pontusAndersson/CyclingHourglass/images/2N3906-Pinout.jpg

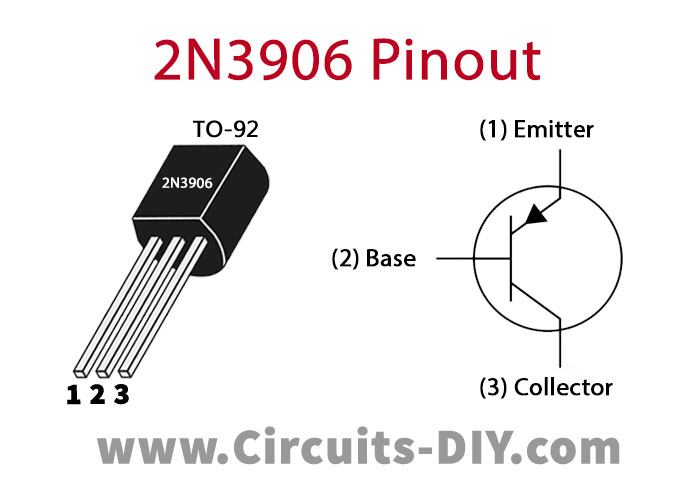
images/2N3906-Pinout.jpg
