pontusAndersson/CyclingHourglass/Schematic/Transponder/BOM.md

# TransponderV3 BOM

Listan, TME-länkar, batteri och bygge ligger i [README.md](README.md).

Orderarkiv: [TME-order-35407144.csv](TME-order-35407144.csv).
