pontusAndersson/CyclingHourglass/images/build imgs/amplifier front.png

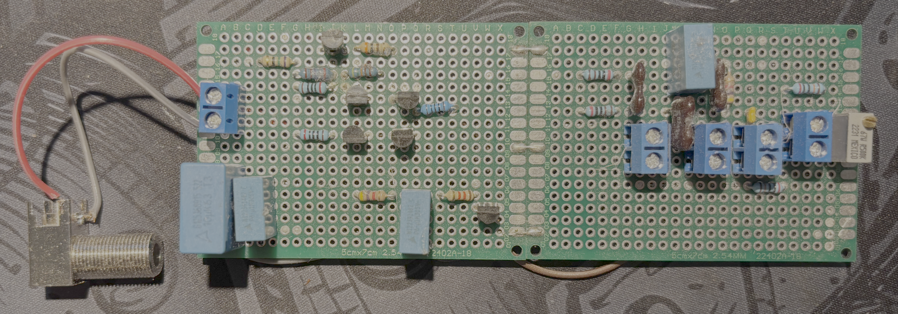
images/build imgs/amplifier front.png
