pontusAndersson/CyclingHourglass/Schematic/Decoder/Decoder.pdf

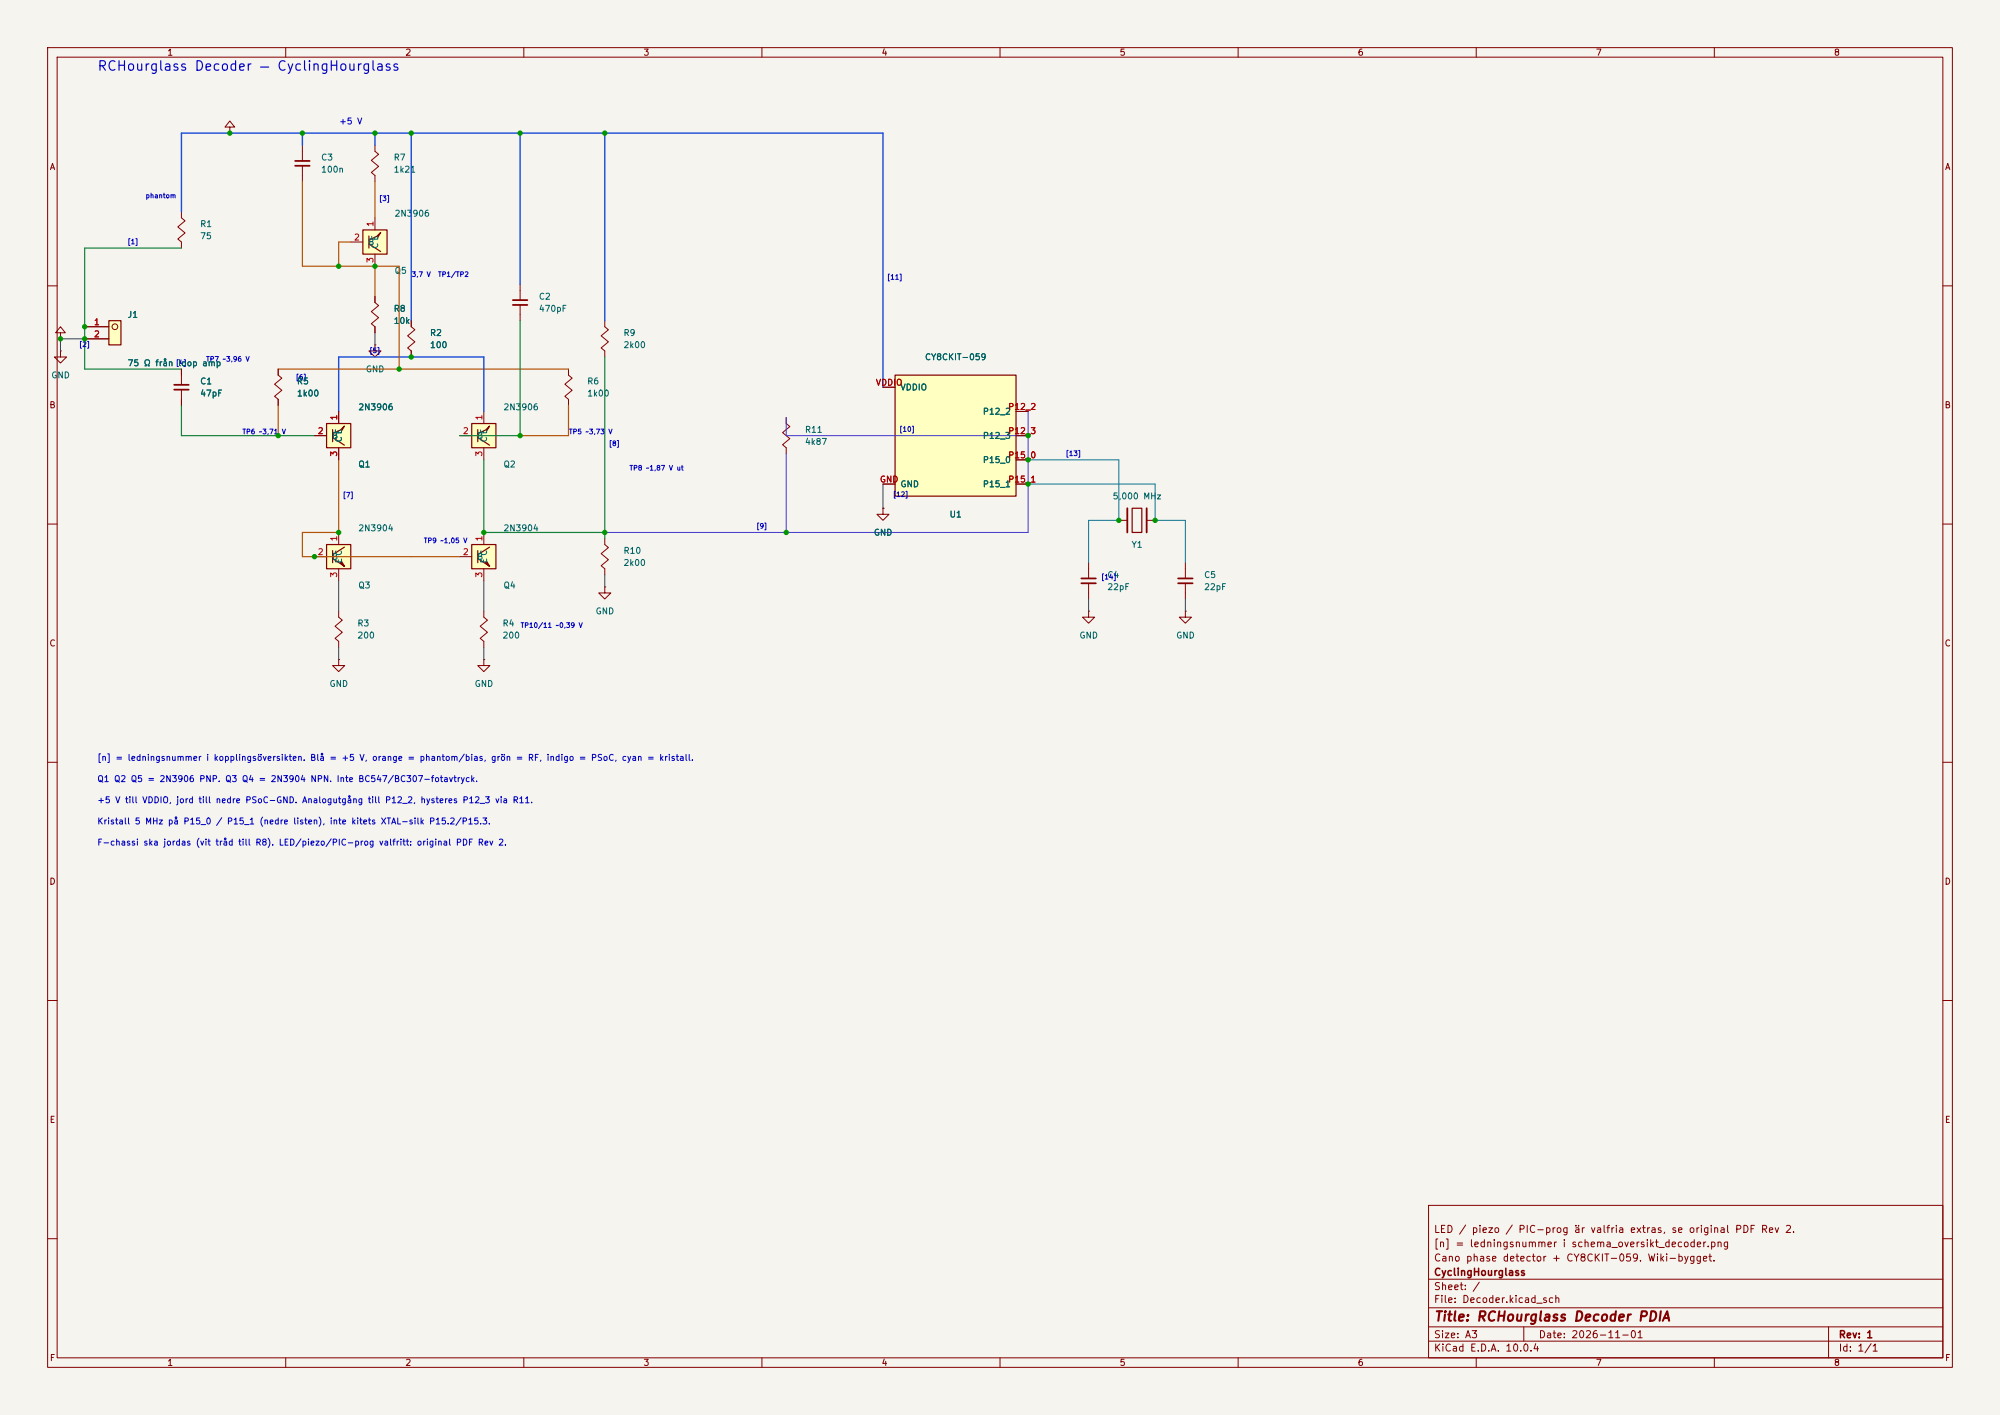
[picture p53: page 1]

[12] [n] = ledningsnummer i kopplingsöversikten. Blå = +5 V, orange = phantom/bias, grön = RF, indigo = PSoC, cyan = kristall. +5 V till VDDIO, jord till nedre PSoC-GND. Analogutgång till P12_2, hysteres P12_3 via R11. F-chassi ska jordas (vit tråd till R8). LED/piezo/PIC-prog valfritt: original PDF Rev 2.

Q1 Q2 Q5 = 2N3906 PNP. Q3 Q4 = 2N3904 NPN. Inte BC547/BC307-fotavtryck. Kristall 5 MHz på P15_0 / P15_1 (nedre listen), inte kitets XTAL-silk P15.2/P15.3.

LED / piezo / PIC-prog är valfria extras, se original PDF Rev 2.
[n] = ledningsnummer i schema_oversikt_decoder.png
Cano phase detector + CY8CKIT-059. Wiki-bygget.
CyclingHourglass
Sheet: /
File: Decoder.kicad_sch
Title: RCHourglass Decoder PDIA

Size: A3 | Rev: 1
KiCad E.D.A. 10.0.4 | Id: 1/1 | F Date: 2026-11-01
