pontusAndersson/CyclingHourglass/Schematic/Decoder/LoopAmplifier.pdf

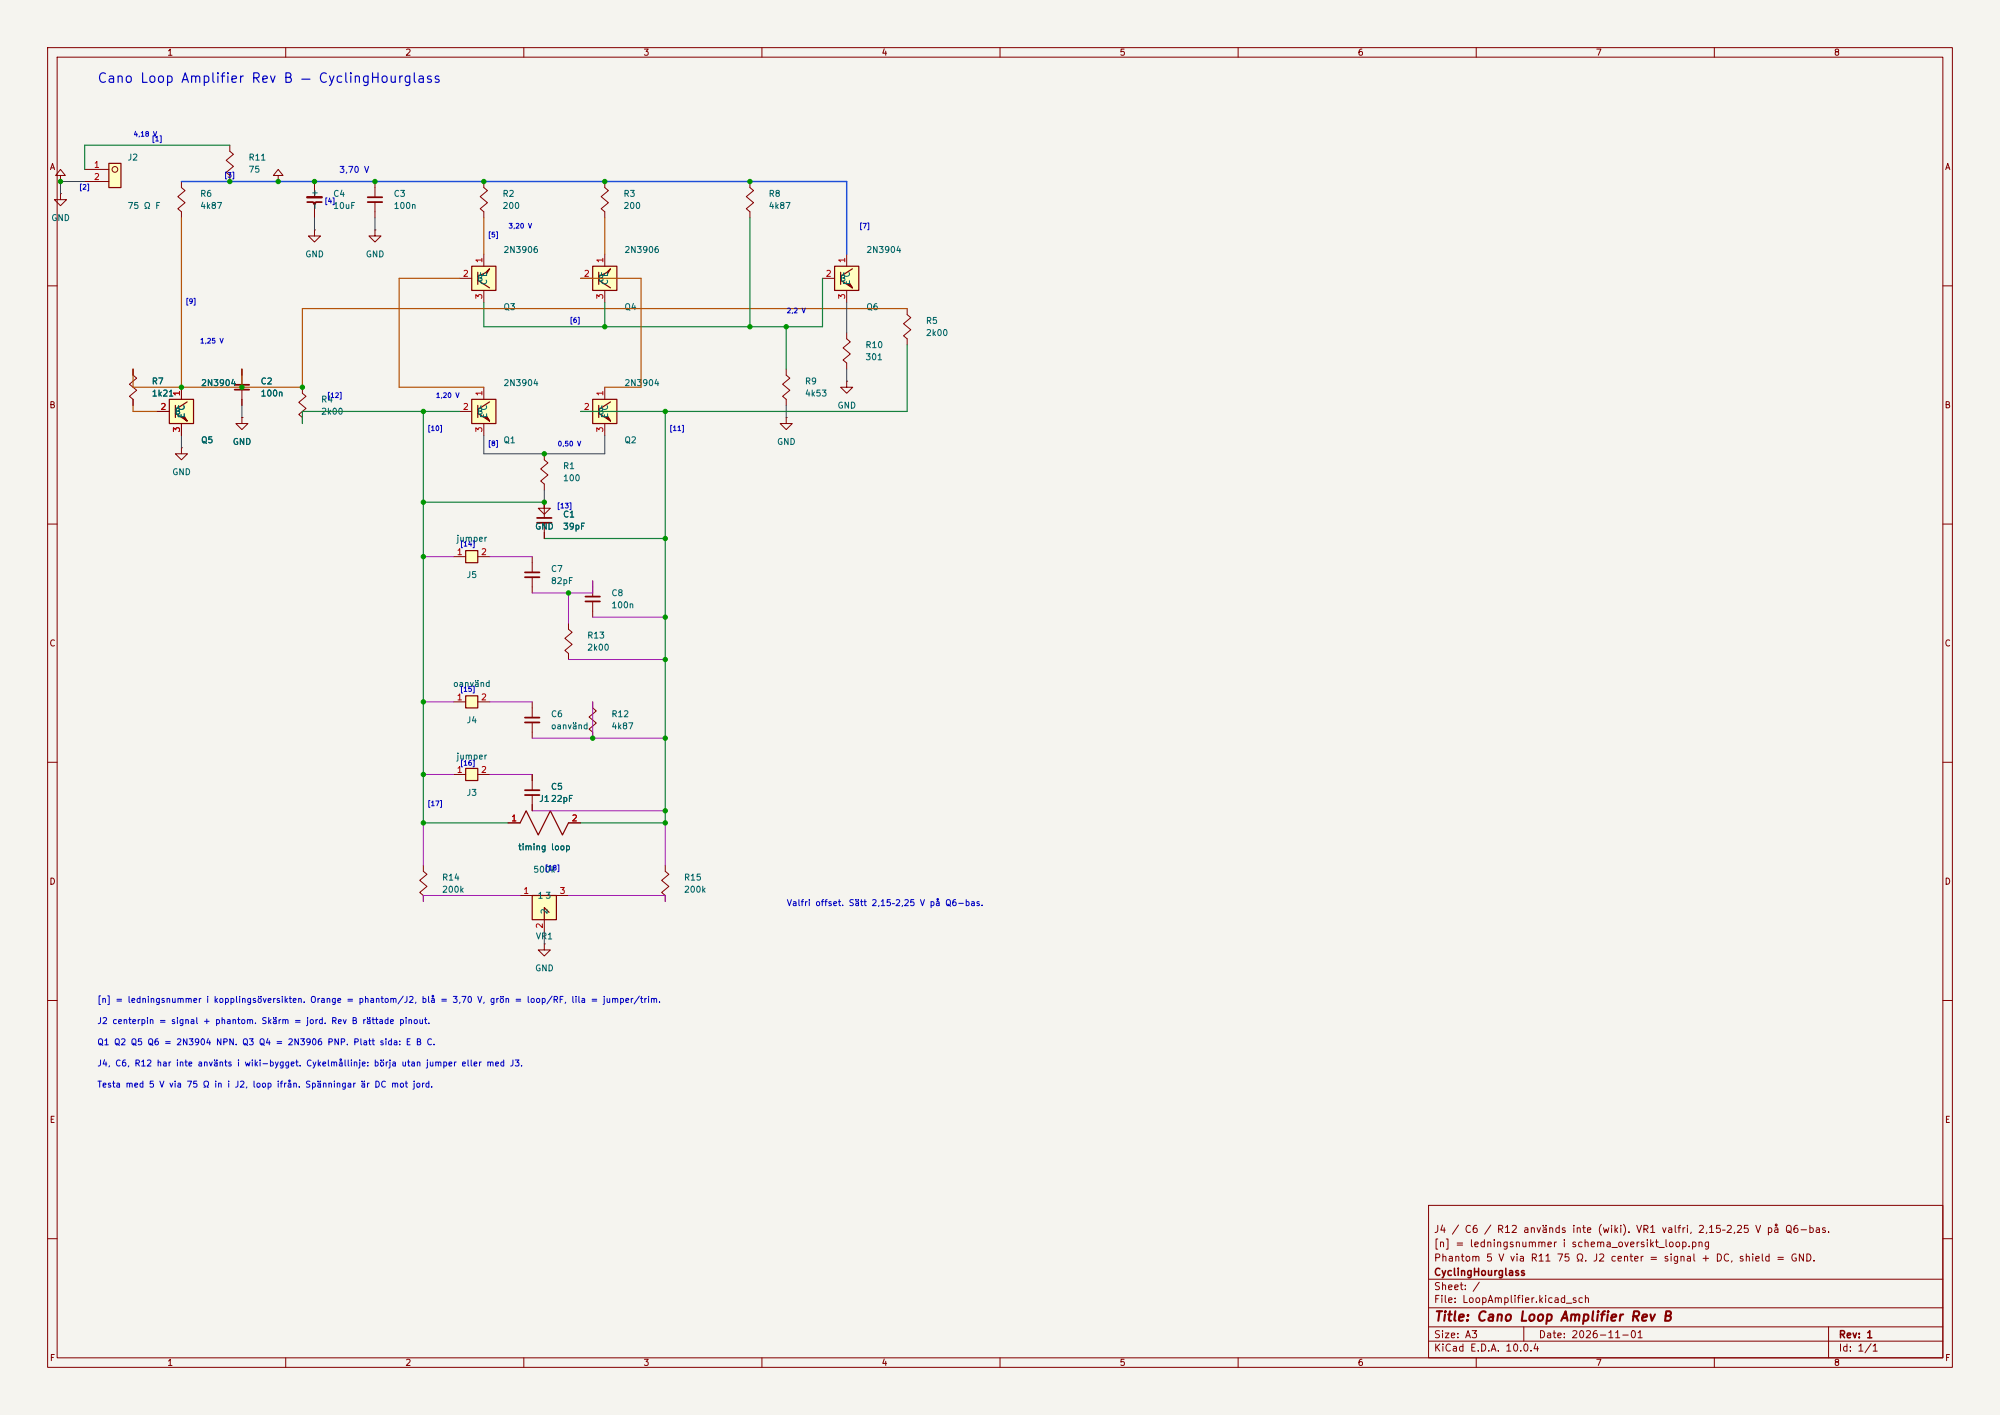
[picture p54: page 1]

[9] 4,18 V Cano Loop Amplifier Rev B — CyclingHourglass

[n] = ledningsnummer i kopplingsöversikten. Orange = phantom/J2, blå = 3,70 V, grön = loop/RF, lila = jumper/trim.

J2 centerpin = signal + phantom. Skärm = jord. Rev B rättade pinout.

J4, C6, R12 har inte använts i wiki-bygget. Cykelmållinje: börja utan jumper eller med J3. Q1 Q2 Q5 Q6 = 2N3904 NPN. Q3 Q4 = 2N3906 PNP. Platt sida: E B C.

Testa med 5 V via 75 Ω in i J2, loop ifrån. Spänningar är DC mot jord.

J4 / C6 / R12 används inte (wiki). VR1 valfri, 2,15–2,25 V på Q6-bas.
[n] = ledningsnummer i schema_oversikt_loop.png
Phantom 5 V via R11 75 Ω. J2 center = signal + DC, shield = GND.
CyclingHourglass
Sheet: /
File: LoopAmplifier.kicad_sch
Title: Cano Loop Amplifier Rev B

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
