pontusAndersson/CyclingHourglass/Schematic/Transponder/TransponderV3.pdf

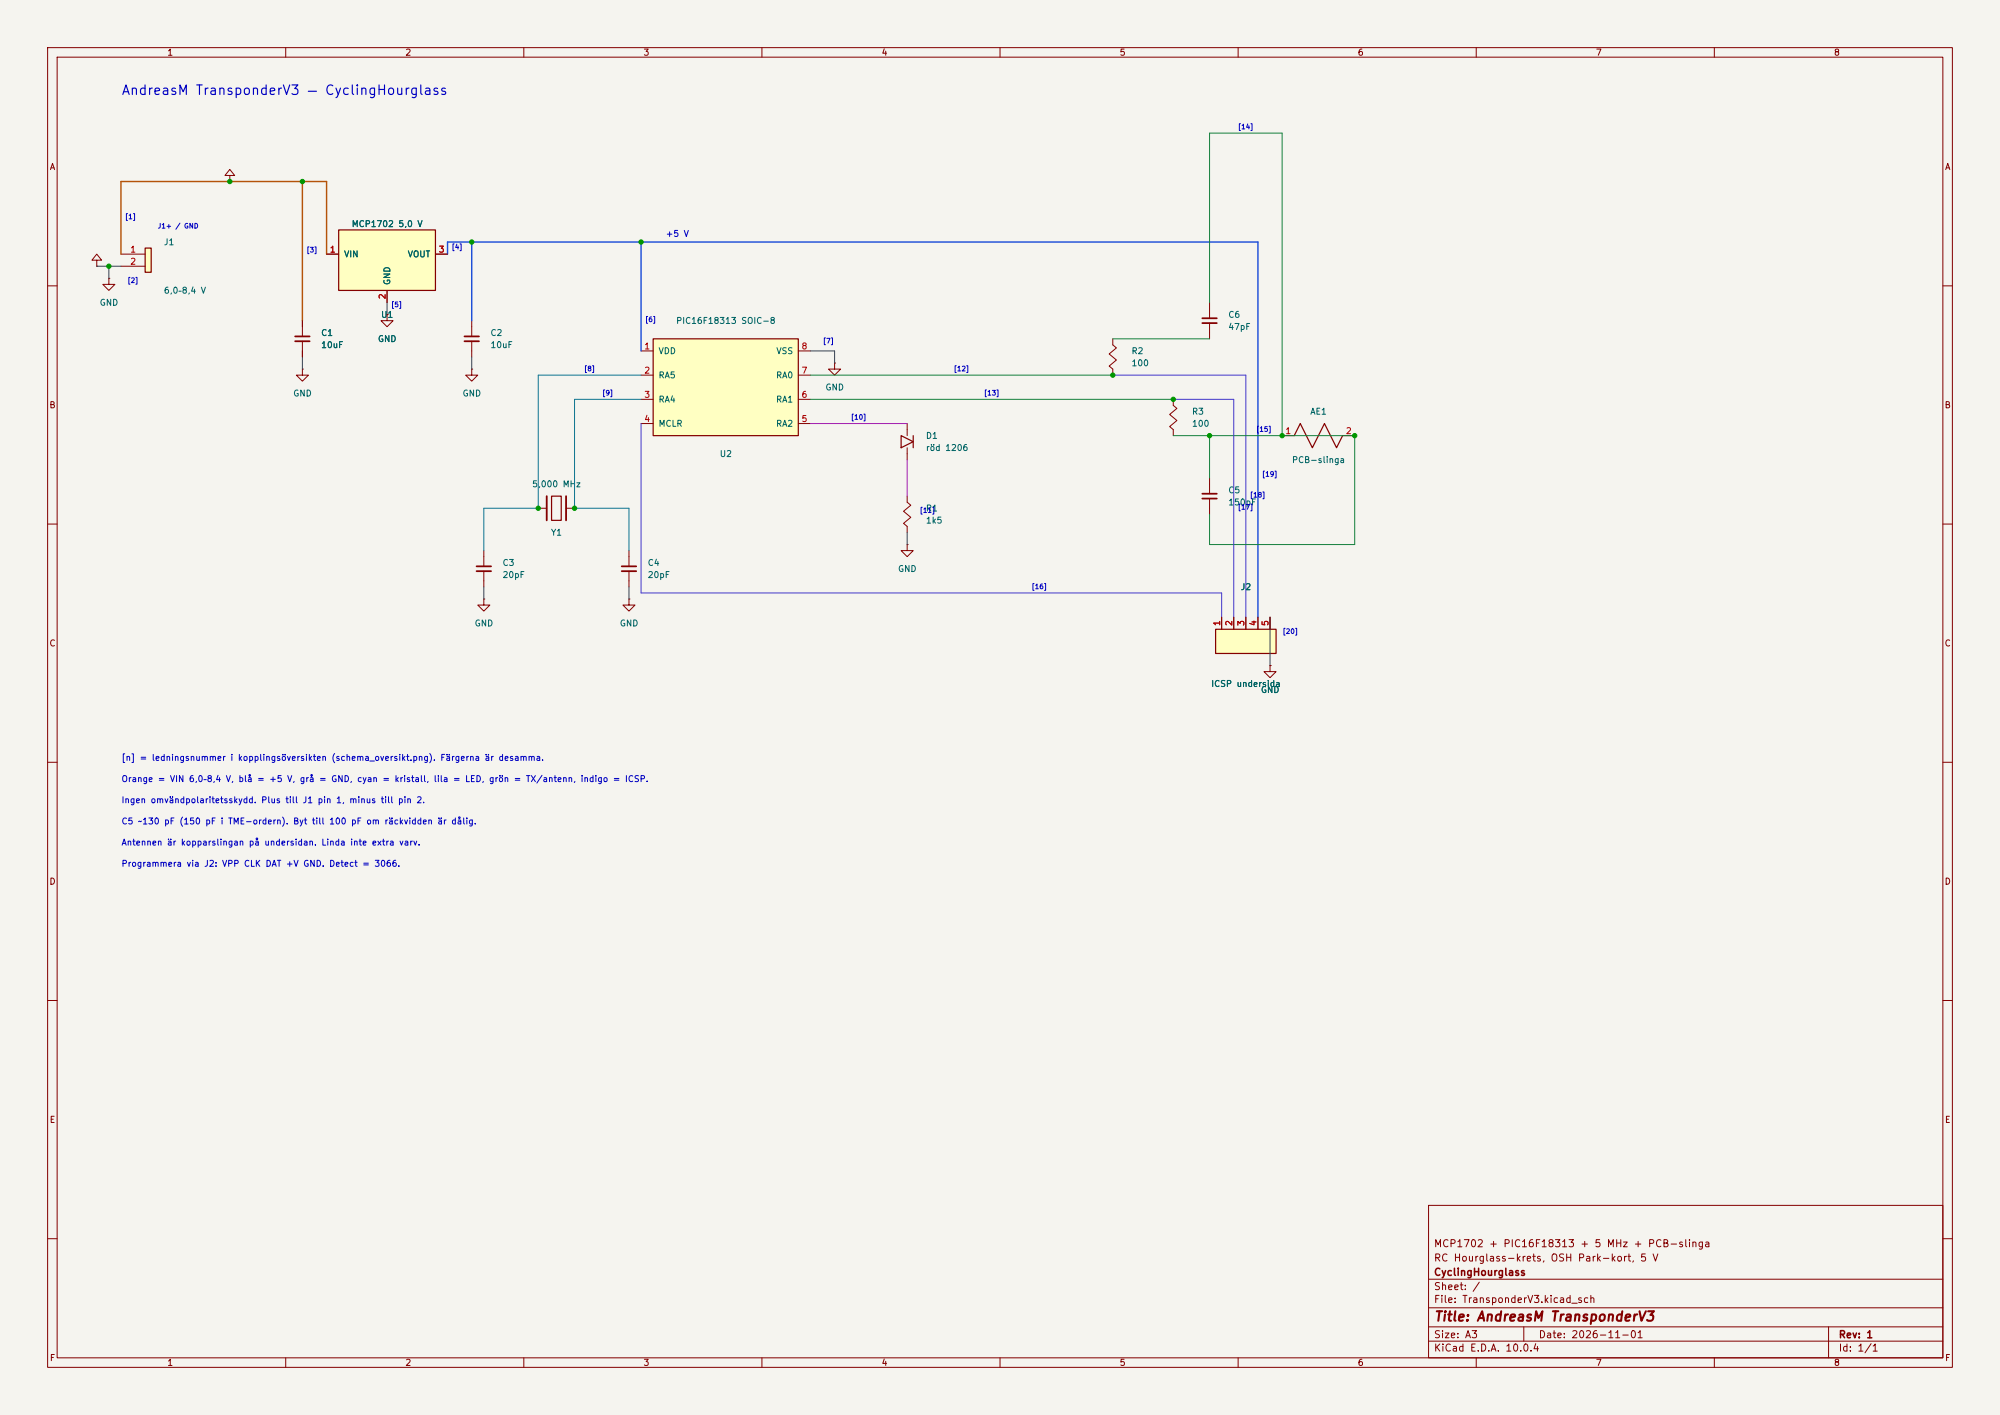
[picture p55: page 1]

[9] C5 ~130 pF (150 pF i TME-ordern). Byt till 100 pF om räckvidden är dålig.

[19] Orange = VIN 6,0–8,4 V, blå = +5 V, grå = GND, cyan = kristall, lila = LED, grön = TX/antenn, indigo = ICSP. Programmera via J2: VPP CLK DAT +V GND. Detect = 3066.

[n] = ledningsnummer i kopplingsöversikten (schema_oversikt.png). Färgerna är desamma.

Ingen omvändpolaritetsskydd. Plus till J1 pin 1, minus till pin 2. Antennen är kopparslingan på undersidan. Linda inte extra varv.

MCP1702 + PIC16F18313 + 5 MHz + PCB-slinga
RC Hourglass-krets, OSH Park-kort, 5 V
CyclingHourglass
Sheet: /
File: TransponderV3.kicad_sch
Title: AndreasM TransponderV3

Size: A3 | Rev: 1 | F Date: 2026-11-01
KiCad E.D.A. 10.0.4 | Id: 1/1
