pontusAndersson/CyclingHourglass/KiCad/MTBHourglass.kicad_pcb

## KiCad design First_Project.kicad_sch


Parts:
A1: Arduino_Nano_v3.x; Arduino_Nano
C1, C2, C3: 100n
D1: LED
R1, R2, R3: 1k
R4: R
SW1, SW2, SW3: SW_Push
U1: MAX30102
U2: SSD1306

Connections:
+5V: A1.27 (+5V), R1.1, R2.1, R3.1, U1.5 (VCC), U2.2 (VCC)
GND: A1.4 (GND), A1.29 (GND), C1.2, C2.2, C3.2, D1.1 (K), SW1.1, SW2.1, SW3.1, U1.4 (GND), U2.1 (GND)
unnamed: A1.5 (D2), C3.1, R3.2, SW3.2
unnamed: A1.6 (D3), C2.1, R2.2, SW2.2
unnamed: A1.7 (D4), C1.1, R1.2, SW1.2
unnamed: A1.15 (D12), R4.1
unnamed: A1.23 (A4), U1.2 (SDA), U2.4 (SDA)
unnamed: A1.24 (A5), U1.3 (SCL), U2.3 (SCL)
unnamed: D1.2 (A), R4.2
