pontusAndersson/CyclingHourglass/Schematic/Decoder/Decoder.kicad_sch

## KiCad design Schematic/Decoder/Decoder.kicad_sch (2026-11-06)

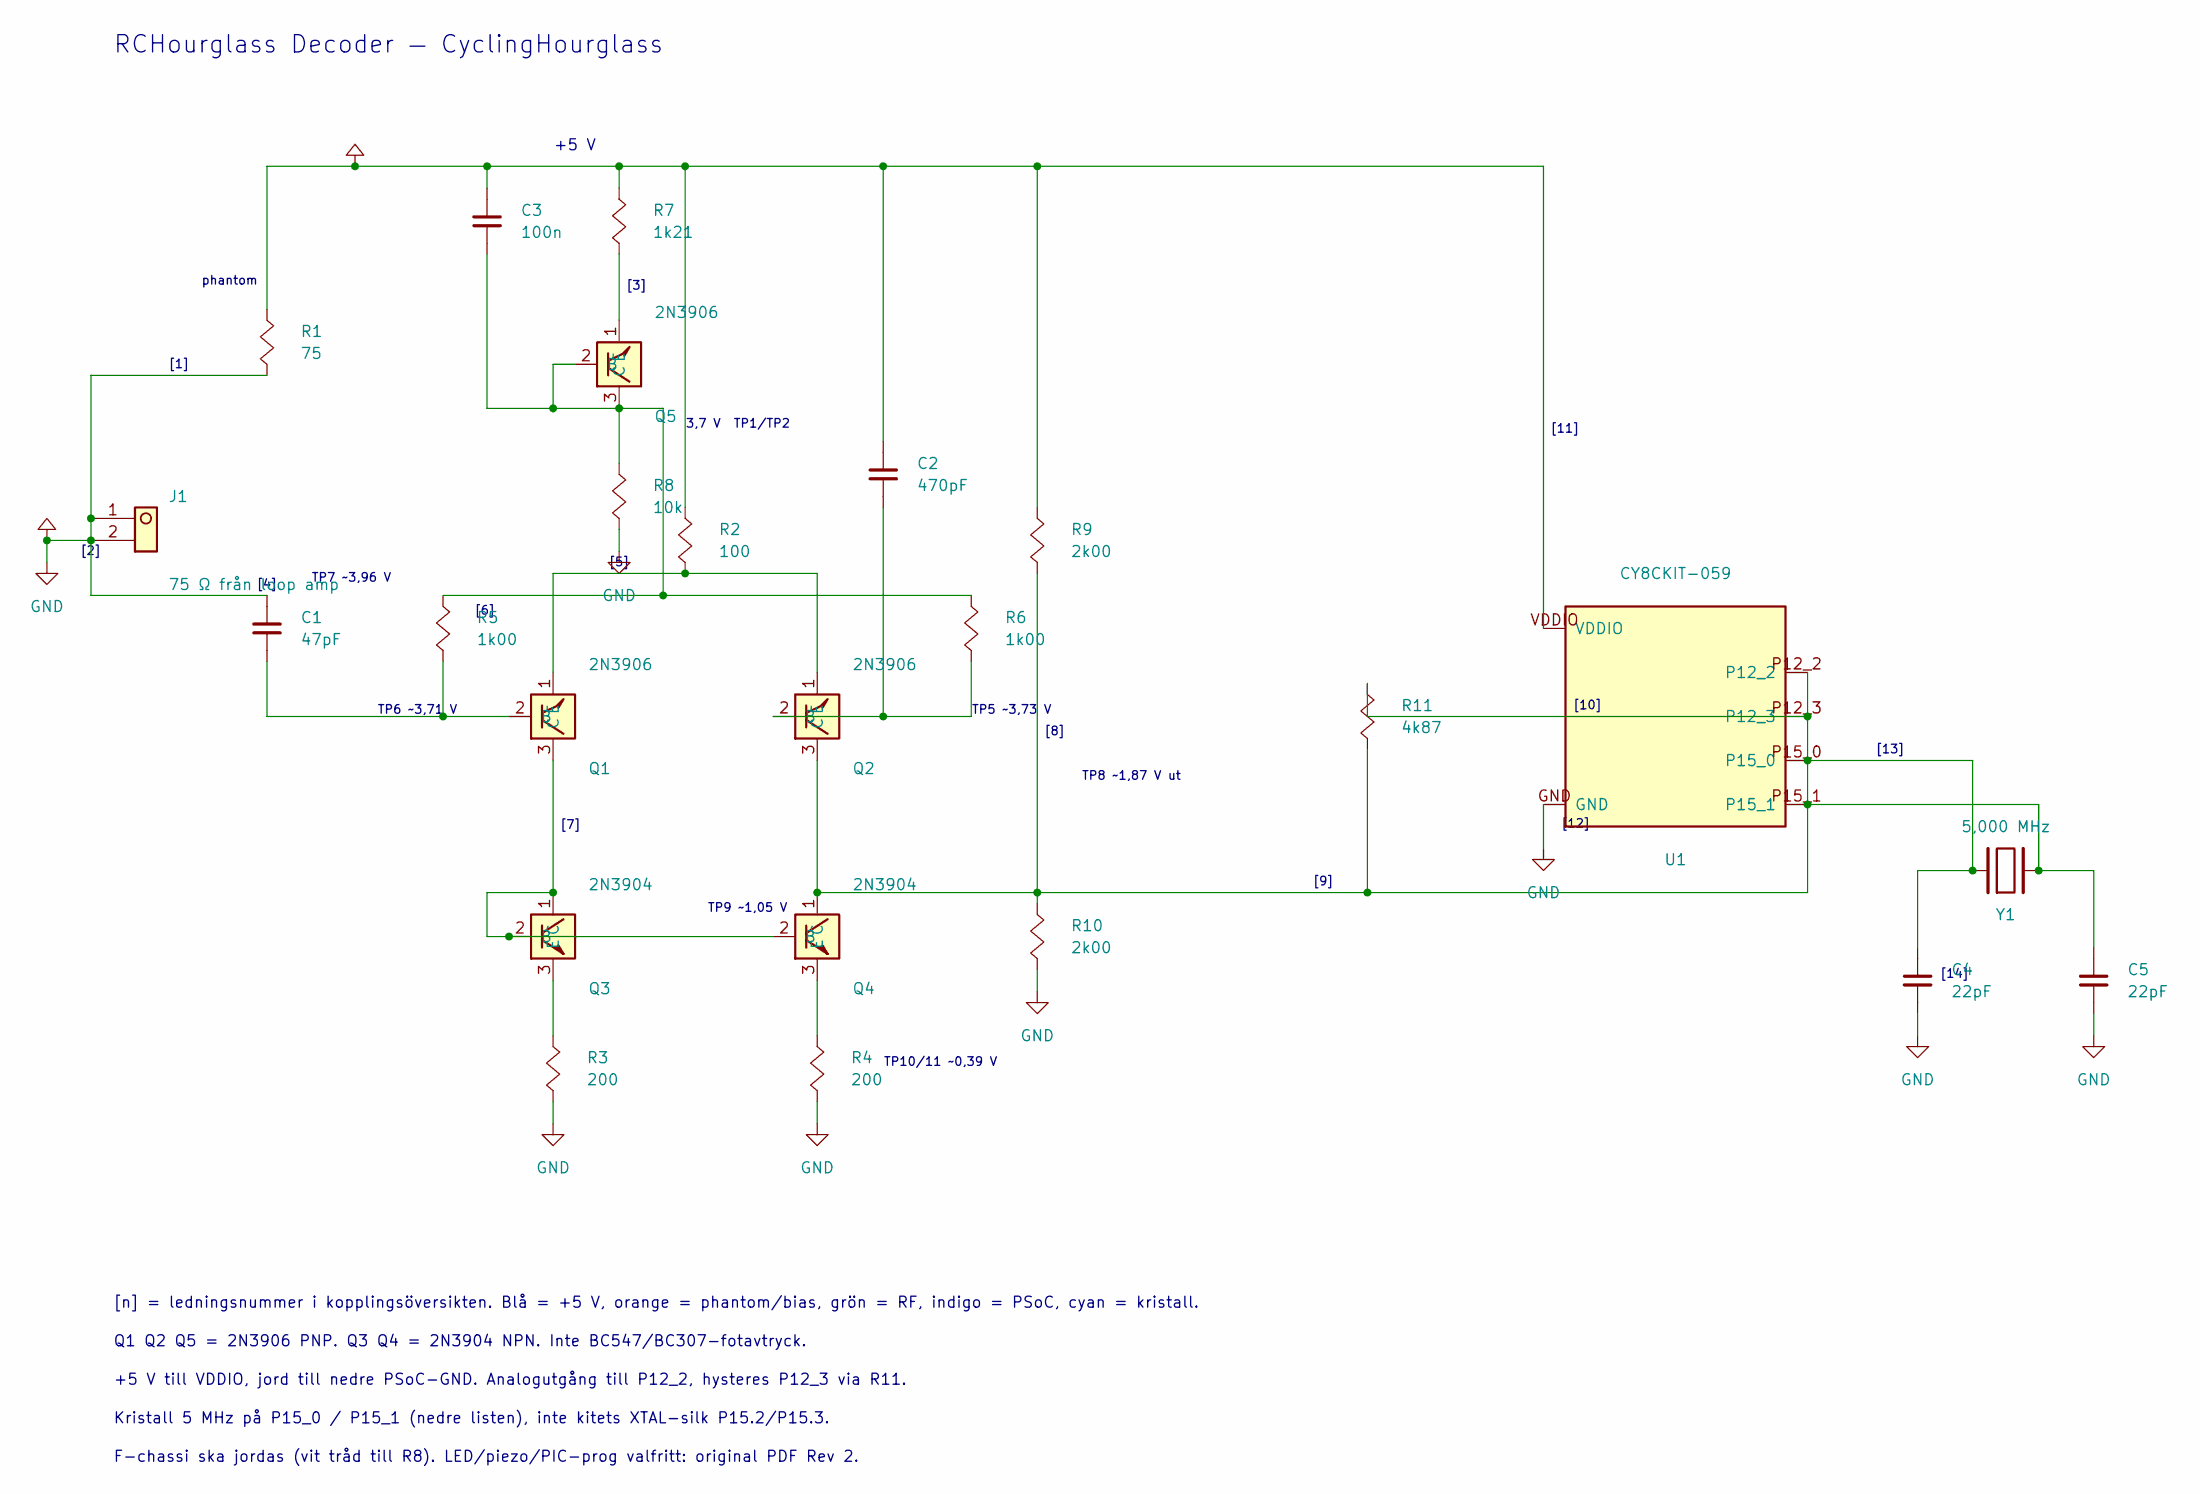
[picture p57: schematic Decoder.kicad_sch]

Parts:
C1: 47pF
C2: 470pF
C3: 100n
C4, C5: 22pF
J1: 75 Ω från loop amp
Q1, Q2, Q5: 2N3906
Q3, Q4: 2N3904
R1: 75
R2: 100
R3, R4: 200
R5, R6: 1k00
R7: 1k21
R8: 10k
R9, R10: 2k00
R11: 4k87
U1: CY8CKIT-059
Y1: 5,000 MHz

Connections:
GND: C1.1, C4.2, C5.2, J1.1 (SIG), J1.2 (SHIELD), R1.2, R3.2, R4.2, R8.2, R10.2, U1.GND
unnamed: C1.2, Q1.2 (B), R5.2
unnamed: C2.1, C3.1, R1.1, R2.1, R7.1, R9.1, U1.VDDIO
unnamed: C2.2, Q2.2 (B), R6.2
unnamed: C3.2, Q5.2 (B), Q5.3 (C), R5.1, R6.1, R8.1
unnamed: C4.1, C5.1, Q2.3 (C), Q4.1 (C), R9.2, R10.1, R11.1, R11.2, U1.P12_2, U1.P12_3, U1.P15_0, U1.P15_1, Y1.1, Y1.2
unnamed: Q1.1 (E), Q2.1 (E), R2.2
unnamed: Q1.3 (C), Q3.1 (C), Q3.2 (B), Q4.2 (B)
unnamed: Q3.3 (E), R3.1
unnamed: Q4.3 (E), R4.1
unnamed: Q5.1 (E), R7.2

Notes on the sheet:
[11]
TP5 ~3,73 V
[5]
TP7 ~3,96 V
TP10/11 ~0,39 V
[4]
[12]
[7]
Kristall 5 MHz på P15_0 / P15_1 (nedre listen), inte kitets XTAL-silk P15.2/P15.3.
[1]
[13]
[8]
+5 V
TP6 ~3,71 V
[14]
[6]
[9]
+5 V till VDDIO, jord till nedre PSoC-GND. Analogutgång till P12_2, hysteres P12_3 via R11.
RCHourglass Decoder — CyclingHourglass
[10]
[n] = ledningsnummer i kopplingsöversikten. Blå = +5 V, orange = phantom/bias, grön = RF, indigo = PSoC, cyan = kristall.
F-chassi ska jordas (vit tråd till R8). LED/piezo/PIC-prog valfritt: original PDF Rev 2.
Q1 Q2 Q5 = 2N3906 PNP. Q3 Q4 = 2N3904 NPN. Inte BC547/BC307-fotavtryck.
[3]
[2]
phantom
3,7 V TP1/TP2
TP8 ~1,87 V ut
TP9 ~1,05 V
