pontusAndersson/CyclingHourglass/Schematic/Decoder/LoopAmplifier.kicad_sch

## KiCad design Schematic/Decoder/LoopAmplifier.kicad_sch (2026-11-06)

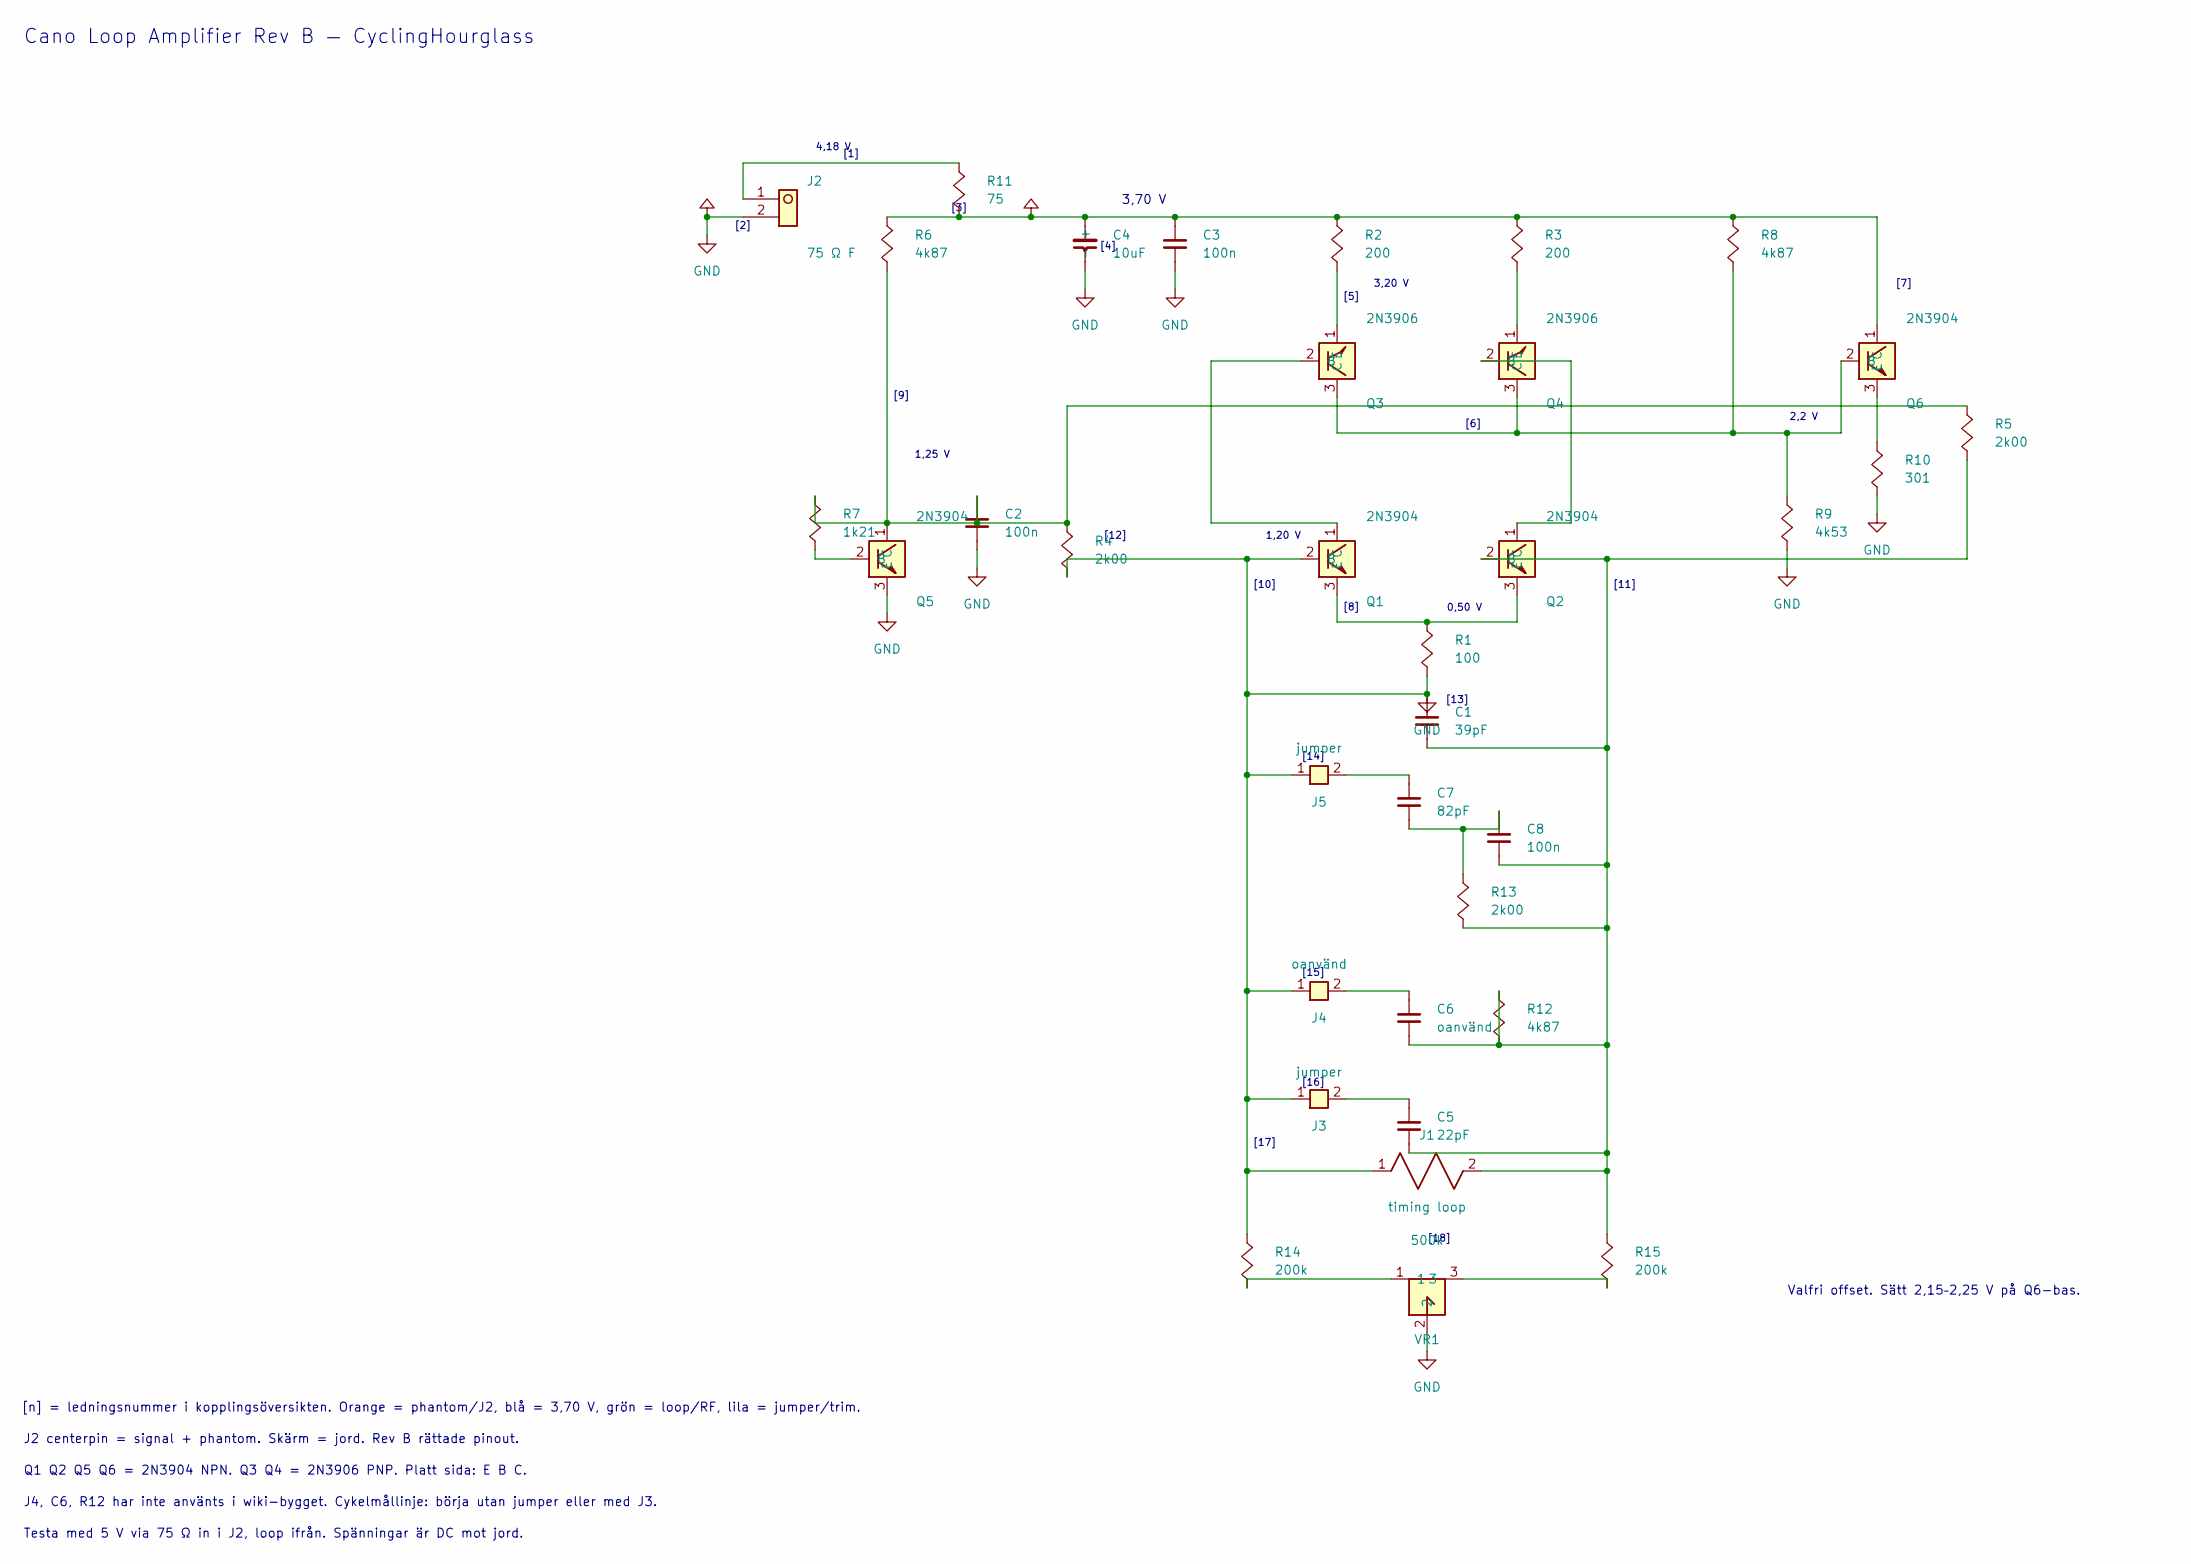
[picture p58: schematic LoopAmplifier.kicad_sch]

Parts:
C1: 39pF
C2, C3, C8: 100n
C4: 10uF
C5: 22pF
C6: oanvänd
C7: 82pF
J1: timing loop
J2: 75 Ω F
J3, J5: jumper
J4: oanvänd
Q1, Q2, Q5, Q6: 2N3904
Q3, Q4: 2N3906
R1: 100
R2, R3: 200
R4, R5, R13: 2k00
R6, R8, R12: 4k87
R7: 1k21
R9: 4k53
R10: 301
R11: 75
R14, R15: 200k
VR1: 500k

Connections:
GND: C1.1, C2.2, C3.2, C4.2 (-), J1.1, J2.2 (SHIELD), J3.1, J4.1, J5.1, Q1.2 (B), Q5.3 (E), R1.2, R4.2, R9.2, R10.2, R14.1, VR1.2
unnamed: C1.2, C5.2, C6.2, C8.2, J1.2, Q2.2 (B), R5.2, R12.1, R12.2, R13.2, R15.1
unnamed: C2.1, Q5.1 (C), R4.1, R5.1, R6.2, R7.1
unnamed: C3.1, C4.1 (+), Q6.1 (C), R2.1, R3.1, R6.1, R8.1, R11.2
unnamed: C5.1, J3.2
unnamed: C6.1, J4.2
unnamed: C7.1, J5.2
unnamed: C7.2, C8.1, R13.1
unnamed: J2.1 (SIG), R11.1
unnamed: Q1.1 (C), Q3.2 (B)
unnamed: Q1.3 (E), Q2.3 (E), R1.1
unnamed: Q2.1 (C), Q4.2 (B)
unnamed: Q3.1 (E), R2.2
unnamed: Q3.3 (C), Q4.3 (C), Q6.2 (B), R8.2, R9.1
unnamed: Q4.1 (E), R3.2
unnamed: Q5.2 (B), R7.2
unnamed: Q6.3 (E), R10.1
unnamed: R14.2, VR1.1
unnamed: R15.2, VR1.3

Notes on the sheet:
[12]
0,50 V
J4, C6, R12 har inte använts i wiki-bygget. Cykelmållinje: börja utan jumper eller med J3.
[9]
[n] = ledningsnummer i kopplingsöversikten. Orange = phantom/J2, blå = 3,70 V, grön = loop/RF, lila = jumper/trim.
Q1 Q2 Q5 Q6 = 2N3904 NPN. Q3 Q4 = 2N3906 PNP. Platt sida: E B C.
[1]
[18]
[15]
[10]
[17]
[4]
Cano Loop Amplifier Rev B — CyclingHourglass
[16]
2,2 V
[3]
[2]
1,25 V
1,20 V
[13]
3,70 V
4,18 V
3,20 V
[5]
J2 centerpin = signal + phantom. Skärm = jord. Rev B rättade pinout.
[14]
[11]
Valfri offset. Sätt 2,15–2,25 V på Q6-bas.
[7]
Testa med 5 V via 75 Ω in i J2, loop ifrån. Spänningar är DC mot jord.
[6]
[8]
