pontusAndersson/CyclingHourglass/Schematic/Transponder/TransponderV3.kicad_sch

## KiCad design Schematic/Transponder/TransponderV3.kicad_sch (2026-11-01)

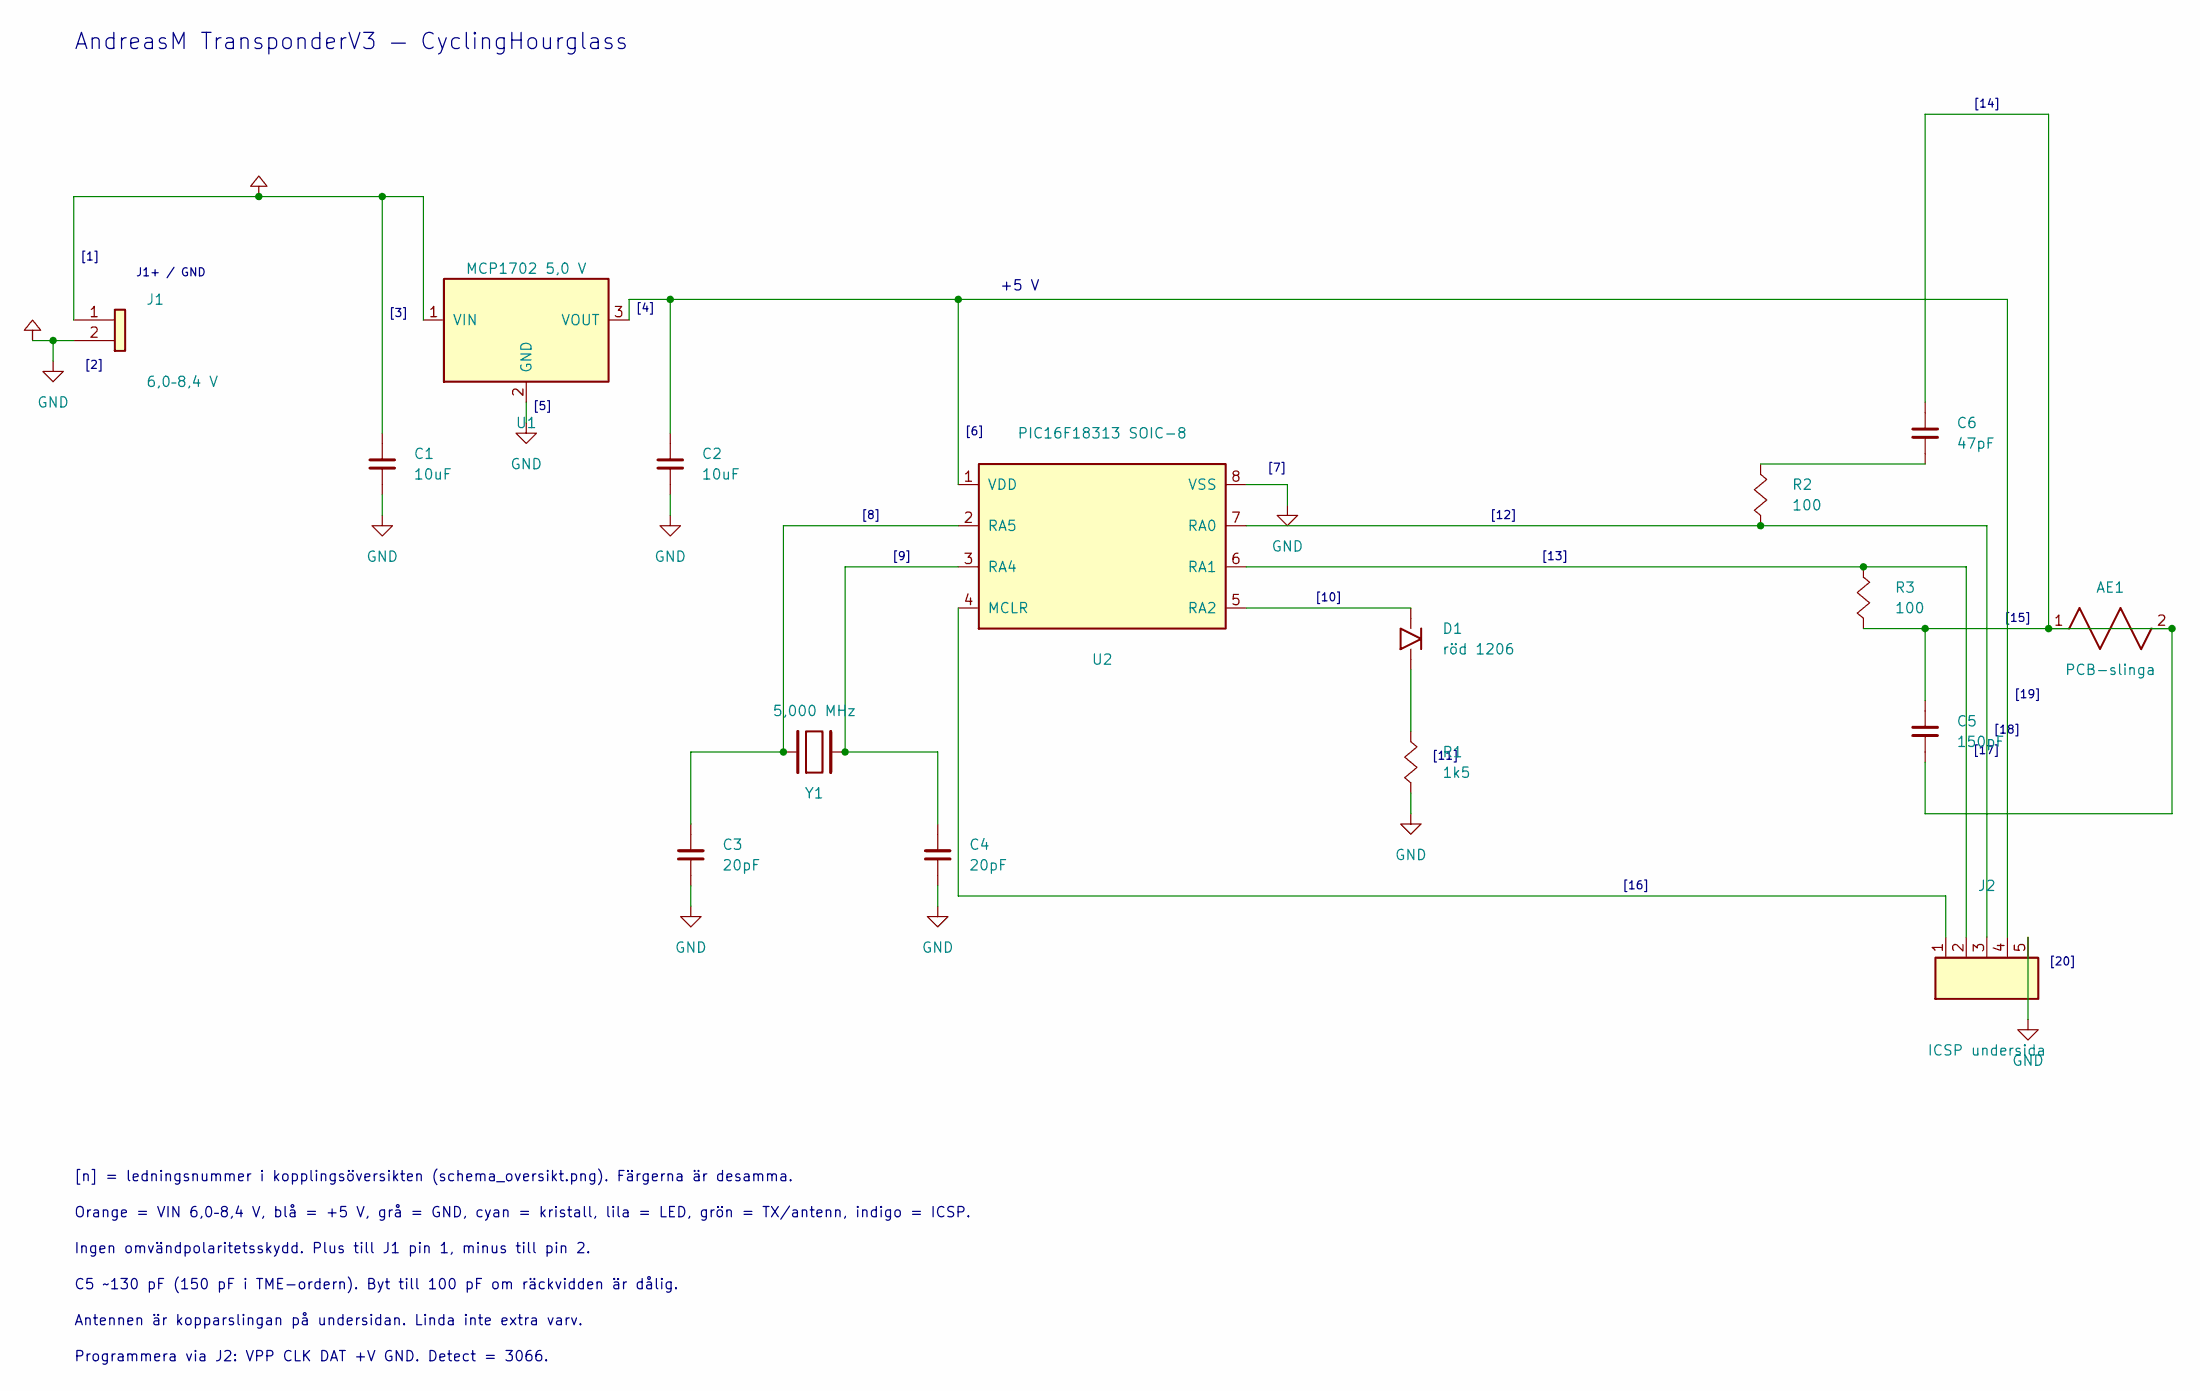
[picture p59: schematic TransponderV3.kicad_sch]

Parts:
AE1: PCB-slinga
C1, C2: 10uF
C3, C4: 20pF
C5: 150pF
C6: 47pF
D1: röd 1206
J1: 6,0–8,4 V
J2: ICSP undersida
R1: 1k5
R2, R3: 100
U1: MCP1702 5,0 V
U2: PIC16F18313 SOIC-8
Y1: 5,000 MHz

Connections:
GND: C1.2, C2.2, C3.2, C4.2, J1.2 (-), J2.5 (GND), R1.2, U1.2 (GND), U2.8 (VSS)
unnamed: AE1.1, AE1.2, C5.1, C5.2, C6.1, R3.2
unnamed: C1.1, J1.1 (+), U1.1 (VIN)
unnamed: C2.1, J2.4 (+V), U1.3 (VOUT), U2.1 (VDD)
unnamed: C3.1, U2.2 (RA5), Y1.1
unnamed: C4.1, U2.3 (RA4), Y1.2
unnamed: C6.2, R2.1
unnamed: D1.1 (A), U2.5 (RA2)
unnamed: D1.2 (K), R1.1
unnamed: J2.1 (VPP), U2.4 (MCLR)
unnamed: J2.2 (CLK), R3.1, U2.6 (RA1)
unnamed: J2.3 (DAT), R2.2, U2.7 (RA0)

Notes on the sheet:
[13]
[14]
Antennen är kopparslingan på undersidan. Linda inte extra varv.
[10]
Ingen omvändpolaritetsskydd. Plus till J1 pin 1, minus till pin 2.
[5]
[11]
[7]
Programmera via J2: VPP CLK DAT +V GND. Detect = 3066.
[16]
Orange = VIN 6,0–8,4 V, blå = +5 V, grå = GND, cyan = kristall, lila = LED, grön = TX/antenn, indigo = ICSP.
[9]
[6]
AndreasM TransponderV3 — CyclingHourglass
[1]
[4]
[2]
[17]
[8]
[3]
[18]
[12]
[15]
[20]
+5 V
[n] = ledningsnummer i kopplingsöversikten (schema_oversikt.png). Färgerna är desamma.
[19]
J1+ / GND
C5 ~130 pF (150 pF i TME-ordern). Byt till 100 pF om räckvidden är dålig.
