pontusAndersson/CyclingHourglass/(commit log)

2026-09-17 BOM and read me update
    [TME-order-35407144.csv]
2026-11-01 Document AndreasM TransponderV3 as the build we use.
    Put assembly, BOM, and battery/voltage notes in the transponder README so the other variants are only pointers.
2026-11-01 Add KiCad schematic and wiring overview for AndreasM TransponderV3.
    [TransponderV3.kicad_sch]
2026-11-01 Refresh TransponderV3 schematic after KiCad 10 upgrade.
    [TransponderV3.kicad_sch]
2026-11-06 Update decoder and loop amplifier schematics and overview diagrams
    Ignore KiCad local history folders (.history/).
    [Decoder.kicad_sch, LoopAmplifier.kicad_sch]
