pontusAndersson/CyclingHourglass/images/build imgs/Amplifier rear.png

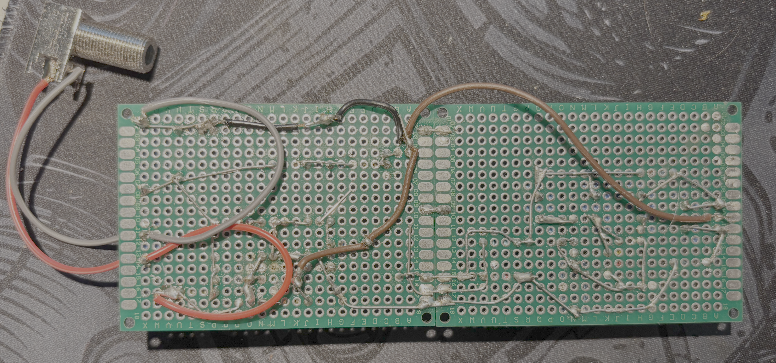
images/build imgs/Amplifier rear.png
